benjohnemmett/Wingman/README.md

# Wingman
Hardware layout and code for a basic fixed wing flight controller.
