benjohnemmett/Wingman/(threads)

Thread 2 (2022-07-28):

ATMega4809 Library to Capture PWM input

benjohnemmett, 2022-07-28:
Write a small library to capture the 4 channels of servo PWM (typically 1 -2 ms @ 50Hz) for the ATMega4809. Keep all platform specific code out of FlightControllerMain.c and in a separate library to keep main code portable. Store captures values as TBD.

Options for storing the the PWM value?
- float 0.0 to 1.0 would be easy to work with and provide high resolution.
- uint8_t would make all operations atomic. Would that be enough resolution?
- Pulse width in ms (uint16_t) would be generic, but non-atomic.

* Note that it would be good to leave the option open for capturing additional PWM channels for future features.

benjohnemmett, 2022-08-17:
Completed using uint16 to store the most recent pulse width value of each channel in microseconds.

\* Note that using 16 bit values will require extra care to ensure that values are accessed atomically.

Closed 2022-08-17.

Thread 3 (2022-07-28):

Write direction control library

benjohnemmett, 2022-07-28:
Write a library function to map PWM input of roll & pitch, stored as TBD, into aircraft body angles (relative to down direction).

This will support a control mode where the operator sticks directly control the aircraft pitch and roll. This should be swappable with other control libraries.

Thread 6 (2022-08-17):

Create PWM Passthrough

benjohnemmett, 2022-08-17:
Create platform specific logic for ATMega4809 that outputs 4 PWM signals that follow the captured input. Use the Timer/Counter Type A.

Test with ATMega4809 test board input capture connected to RC receiver and output connected to aircraft servos or logic analyzer.

\* This may be replaced later with external PWM control.

benjohnemmett, 2022-08-28:
This was tested with an RC plane and was able to control elevator, rudder, ailerons, & propeller ESC. All four channels could not be tested with actual motors simultaneously without issues. It appears likely to be a current draw issue because the RC transmitter alarm sounded for low RX power. Even after disconnecting all but one motor, the MCU would not operate until it was restarted (done by reflashing the same program).

benjohnemmett, 2022-08-30:
Further power testing pinpointed the power issue that was mentioned in the last comment to be in the jumper wires used to power the servos from the ESC. By just extending the 3-pin connection coming from the ESC to the RC receiver with a pair of jumper wires, it was enough to cause low power issues where there were none before.

I may return to this testing with better jumper wires later on. For now, I measured the current draw of each servo motor independently to estimate the total power requirements of the servo power rail. I found they typically run 2.5 mA idle and 50 to 200 mA active which means that the servo power rail will need to support at least 800 mA for power drawn from the ESC connector to power the other 4 servos (rudder, elevator, 2x ailerons). I feel like that is enough to confidently move forward with the hardware design.

Closed 2022-08-28.
