benjohnemmett/Wingman/hardware/WingBoard/WingBoard.kicad_pcb

## KiCad design hardware/WingBoard/WingBoard.kicad_pcb (2022-09-21)

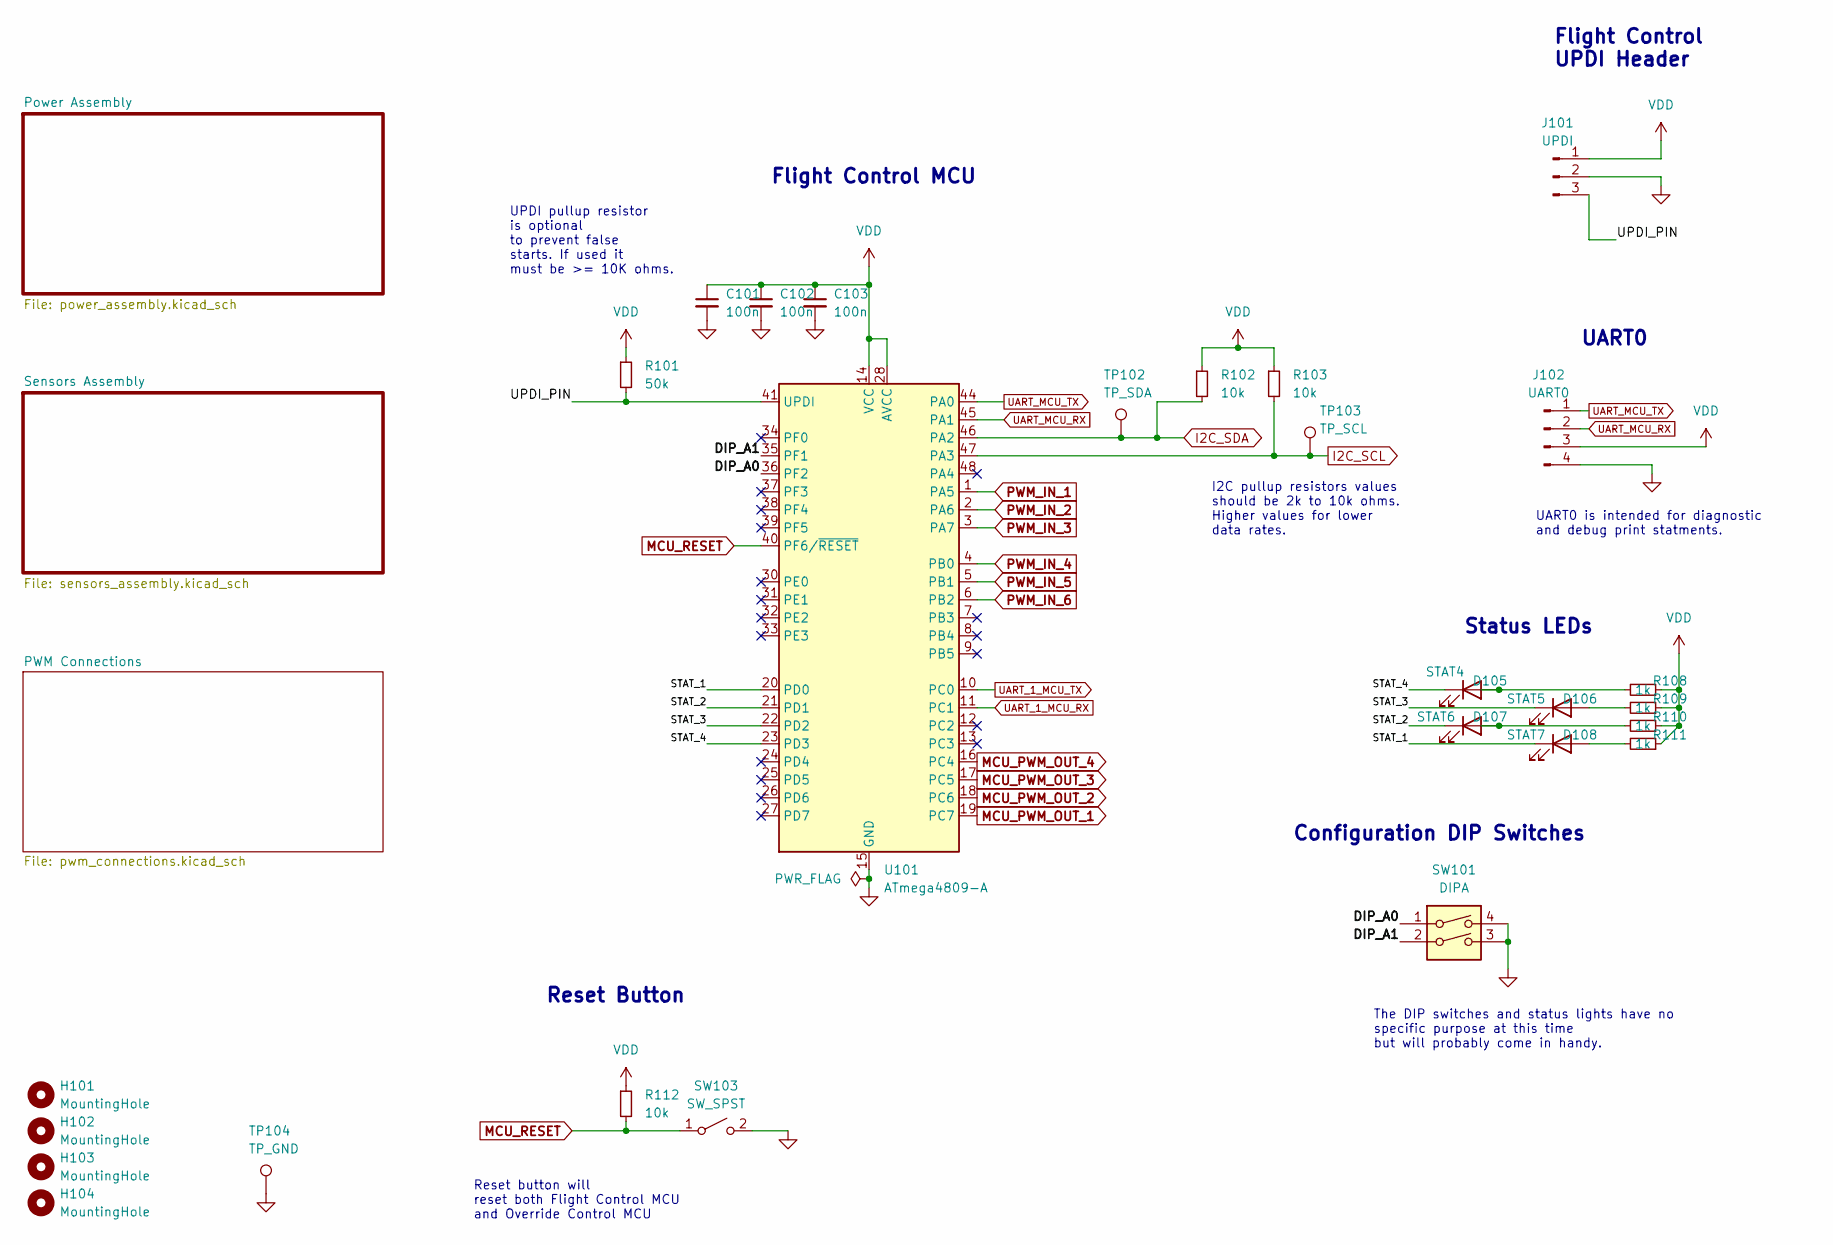
[picture p1: schematic WingBoard.kicad_sch]

Parts:
C101, C102, C103: 100n; C_0805_2012Metric_Pad1.18x1.45mm_HandSolder
D105: STAT4; LED_0805_2012Metric_Pad1.15x1.40mm_HandSolder
D106: STAT5; LED_0805_2012Metric_Pad1.15x1.40mm_HandSolder
D107: STAT6; LED_0805_2012Metric_Pad1.15x1.40mm_HandSolder
D108: STAT7; LED_0805_2012Metric_Pad1.15x1.40mm_HandSolder
H101, H102, H103, H104: MountingHole; MountingHole_3mm_Pad_Via
J101: UPDI; PinHeader_1x03_P2.54mm_Vertical
J102: UART0; PinHeader_1x04_P2.54mm_Vertical
R101: 50k; R_0805_2012Metric_Pad1.20x1.40mm_HandSolder
R102, R103, R112: 10k; R_0805_2012Metric_Pad1.20x1.40mm_HandSolder
R108, R109, R110, R111: 1k; R_0805_2012Metric_Pad1.20x1.40mm_HandSolder
SW101: DIPA; SW_DIP_SPSTx02_Slide_Copal_CHS-02B_W7.62mm_P1.27mm
SW103: SW_SPST; R-668127
TP102: TP_SDA; TestPoint_Pad_D1.5mm
TP103: TP_SCL; TestPoint_Pad_D1.5mm
TP104: TP_GND; TestPoint_Pad_D1.5mm
U101: ATmega4809-A; TQFP-48_7x7mm_P0.5mm

Connections:
/DIP_A0: SW101.1, U101.36 (PF2)
/DIP_A1: SW101.2, U101.35 (PF1)
/STAT_1: D108.1 (K), U101.20 (PD0)
/STAT_2: D107.1 (K), U101.21 (PD1)
/STAT_3: D106.1 (K), U101.22 (PD2)
/STAT_4: D105.1 (K), U101.23 (PD3)
/UPDI_PIN: J101.3, R101.2, U101.41 (UPDI)
GND: C101.2, C102.2, C103.2, J101.2, J102.4, SW101.3, SW101.4, SW103.2 (B), TP104.1, U101.15 (GND), U101.29 (GND), U101.43 (GND); also elsewhere on the board
I2C_SCL: R103.2, TP103.1, U101.47 (PA3); also elsewhere on the board
I2C_SDA: R102.2, TP102.1, U101.46 (PA2); also elsewhere on the board
MCU_PWM_OUT_1: U101.19 (PC7); also elsewhere on the board
MCU_PWM_OUT_2: U101.18 (PC6); also elsewhere on the board
MCU_PWM_OUT_3: U101.17 (PC5); also elsewhere on the board
MCU_PWM_OUT_4: U101.16 (PC4); also elsewhere on the board
MCU_RESET: R112.2, SW103.1 (A), U101.40 (PF6/~RESET); also elsewhere on the board
unnamed: D105.2 (A), R108.2
unnamed: D106.2 (A), R109.2
unnamed: D107.2 (A), R110.2
unnamed: D108.2 (A), R111.2
PWM_IN_1: U101.1 (PA5); also elsewhere on the board
PWM_IN_2: U101.2 (PA6); also elsewhere on the board
PWM_IN_3: U101.3 (PA7); also elsewhere on the board
PWM_IN_4: U101.4 (PB0); also elsewhere on the board
PWM_IN_5: U101.5 (PB1); also elsewhere on the board
PWM_IN_6: U101.6 (PB2); also elsewhere on the board
UART_1_MCU_RX: U101.11 (PC1); also elsewhere on the board
UART_1_MCU_TX: U101.10 (PC0); also elsewhere on the board
UART_MCU_RX: J102.2, U101.45 (PA1)
UART_MCU_TX: J102.1, U101.44 (PA0)
VDD: C101.1, C102.1, C103.1, J101.1, J102.3, R101.1, R102.1, R103.1, R108.1, R109.1, R110.1, R111.1, R112.1, U101.14 (VCC), U101.28 (AVCC), U101.42 (VCC); also elsewhere on the board

Notes on the sheet:
Configuration DIP Switches
Reset Button
Flight Control MCU
UPDI pullup resistor is optional to prevent false starts. If used it must be >= 10K ohms.
The DIP switches and status lights have no specific purpose at this time but will probably come in handy.
Reset button will reset both Flight Control MCU and Override Control MCU
Flight Control UPDI Header
Status LEDs
UART0 is intended for diagnostic and debug print statments.
I2C pullup resistors values should be 2k to 10k ohms. Higher values for lower data rates.
UART0

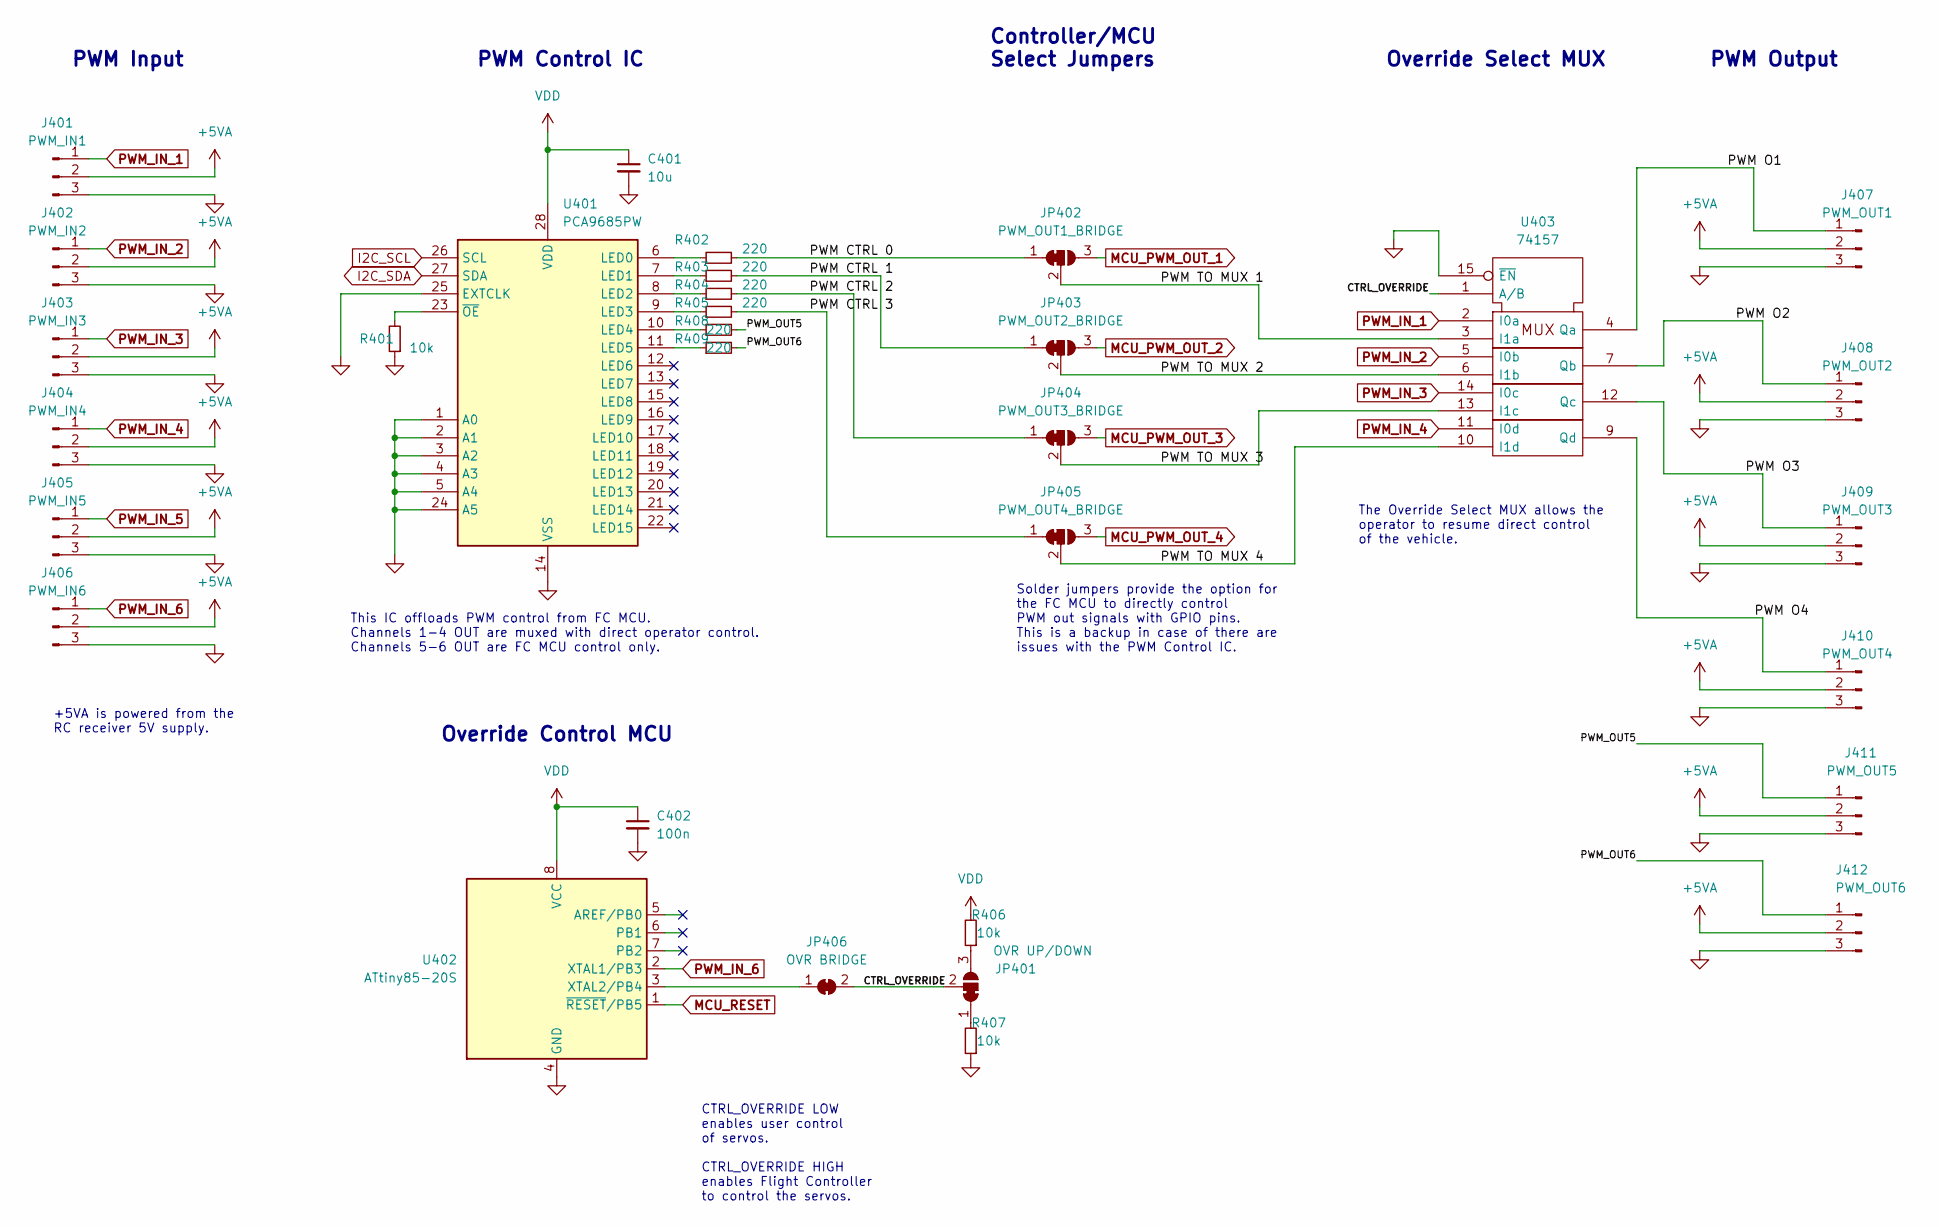
[picture p2: schematic pwm_connections.kicad_sch]

Parts:
C401: 10u; C_0805_2012Metric_Pad1.18x1.45mm_HandSolder
C402: 100n; C_0805_2012Metric_Pad1.18x1.45mm_HandSolder
J401: PWM_IN1; PinHeader_1x03_P2.54mm_Vertical
J402: PWM_IN2; PinHeader_1x03_P2.54mm_Vertical
J403: PWM_IN3; PinHeader_1x03_P2.54mm_Vertical
J404: PWM_IN4; PinHeader_1x03_P2.54mm_Vertical
J405: PWM_IN5; PinHeader_1x03_P2.54mm_Vertical
J406: PWM_IN6; PinHeader_1x03_P2.54mm_Vertical
J407: PWM_OUT1; PinHeader_1x03_P2.54mm_Vertical
J408: PWM_OUT2; PinHeader_1x03_P2.54mm_Vertical
J409: PWM_OUT3; PinHeader_1x03_P2.54mm_Vertical
J410: PWM_OUT4; PinHeader_1x03_P2.54mm_Vertical
J411: PWM_OUT5; PinHeader_1x03_P2.54mm_Vertical
J412: PWM_OUT6; PinHeader_1x03_P2.54mm_Vertical
JP401: OVR UP/DOWN; SolderJumper-3_P1.3mm_Bridged2Bar12_Pad1.0x1.5mm
JP402: PWM_OUT1_BRIDGE; SolderJumper-3_P1.3mm_Bridged12_Pad1.0x1.5mm
JP403: PWM_OUT2_BRIDGE; SolderJumper-3_P1.3mm_Bridged12_Pad1.0x1.5mm
JP404: PWM_OUT3_BRIDGE; SolderJumper-3_P1.3mm_Bridged12_Pad1.0x1.5mm
JP405: PWM_OUT4_BRIDGE; SolderJumper-3_P1.3mm_Bridged12_Pad1.0x1.5mm
JP406: OVR BRIDGE; SolderJumper-2_P1.3mm_Bridged2Bar_RoundedPad1.0x1.5mm
R401, R406, R407: 10k; R_0805_2012Metric_Pad1.20x1.40mm_HandSolder
R402, R403, R404, R405, R408, R409: 220; R_0805_2012Metric_Pad1.20x1.40mm_HandSolder
U401: PCA9685PW; TSSOP-28_4.4x9.7mm_P0.65mm
U402: ATtiny85-20S; SOIC-8W_5.3x5.3mm_P1.27mm
U403: 74157; SOP65P640X120-16N

Connections:
+5VA: J401.2, J402.2, J403.2, J404.2, J405.2, J406.2, J407.2, J408.2, J409.2, J410.2, J411.2, J412.2; also elsewhere on the board
/PWM Connections/CTRL_OVERRIDE: JP401.2 (C), JP406.2 (B), U403.1 (A/B)
/PWM Connections/PWM CTRL 0: JP402.1 (A), R402.2
/PWM Connections/PWM CTRL 1: JP403.1 (A), R403.2
/PWM Connections/PWM CTRL 2: JP404.1 (A), R404.2
/PWM Connections/PWM CTRL 3: JP405.1 (A), R405.2
/PWM Connections/PWM O1: J407.1, U403.4 (Qa)
/PWM Connections/PWM O2: J408.1, U403.7 (Qb)
/PWM Connections/PWM O3: J409.1, U403.12 (Qc)
/PWM Connections/PWM O4: J410.1, U403.9 (Qd)
/PWM Connections/PWM TO MUX 1: JP402.2 (C), U403.3 (I1a)
/PWM Connections/PWM TO MUX 2: JP403.2 (C), U403.6 (I1b)
/PWM Connections/PWM TO MUX 3: JP404.2 (C), U403.13 (I1c)
/PWM Connections/PWM TO MUX 4: JP405.2 (C), U403.10 (I1d)
/PWM Connections/PWM_OUT5: J411.1, R408.2
/PWM Connections/PWM_OUT6: J412.1, R409.2
GND: C401.2, C402.2, J401.3, J402.3, J403.3, J404.3, J405.3, J406.3, J407.3, J408.3, J409.3, J410.3, J411.3, J412.3, R401.1, R407.1, U401.1 (A0), U401.2 (A1), U401.3 (A2), U401.4 (A3), U401.5 (A4), U401.14 (VSS), U401.24 (A5), U401.25 (EXTCLK), U402.4 (GND), U403.8 (GND), U403.15 (~EN); also elsewhere on the board
I2C_SCL: U401.26 (SCL); also elsewhere on the board
I2C_SDA: U401.27 (SDA); also elsewhere on the board
MCU_PWM_OUT_1: JP402.3 (B); also elsewhere on the board
MCU_PWM_OUT_2: JP403.3 (B); also elsewhere on the board
MCU_PWM_OUT_3: JP404.3 (B); also elsewhere on the board
MCU_PWM_OUT_4: JP405.3 (B); also elsewhere on the board
MCU_RESET: U402.1 (~RESET/PB5); also elsewhere on the board
unnamed: JP401.1 (A), R407.2
unnamed: JP401.3 (B), R406.1
unnamed: JP406.1 (A), U402.3 (XTAL2/PB4)
unnamed: R401.2, U401.23 (~OE)
unnamed: R402.1, U401.6 (LED0)
unnamed: R403.1, U401.7 (LED1)
unnamed: R404.1, U401.8 (LED2)
unnamed: R405.1, U401.9 (LED3)
unnamed: R408.1, U401.10 (LED4)
unnamed: R409.1, U401.11 (LED5)
PWM_IN_1: J401.1, U403.2 (I0a); also elsewhere on the board
PWM_IN_2: J402.1, U403.5 (I0b); also elsewhere on the board
PWM_IN_3: J403.1, U403.14 (I0c); also elsewhere on the board
PWM_IN_4: J404.1, U403.11 (I0d); also elsewhere on the board
PWM_IN_5: J405.1; also elsewhere on the board
PWM_IN_6: J406.1, U402.2 (XTAL1/PB3); also elsewhere on the board
VDD: C401.1, C402.1, R406.2, U401.28 (VDD), U402.8 (VCC), U403.16 (VDD); also elsewhere on the board

Notes on the sheet:
+5VA is powered from the RC receiver 5V supply.
CTRL_OVERRIDE LOW enables user control of servos. CTRL_OVERRIDE HIGH enables Flight Controller to control the servos.
PWM Control IC
The Override Select MUX allows the operator to resume direct control of the vehicle.
PWM Input
PWM Output
Override Control MCU
Solder jumpers provide the option for the FC MCU to directly control PWM out signals with GPIO pins. This is a backup in case of there are issues with the PWM Control IC.
Controller/MCU Select Jumpers
This IC offloads PWM control from FC MCU. Channels 1-4 OUT are muxed with direct operator control. Channels 5-6 OUT are FC MCU control only.
Override Select MUX

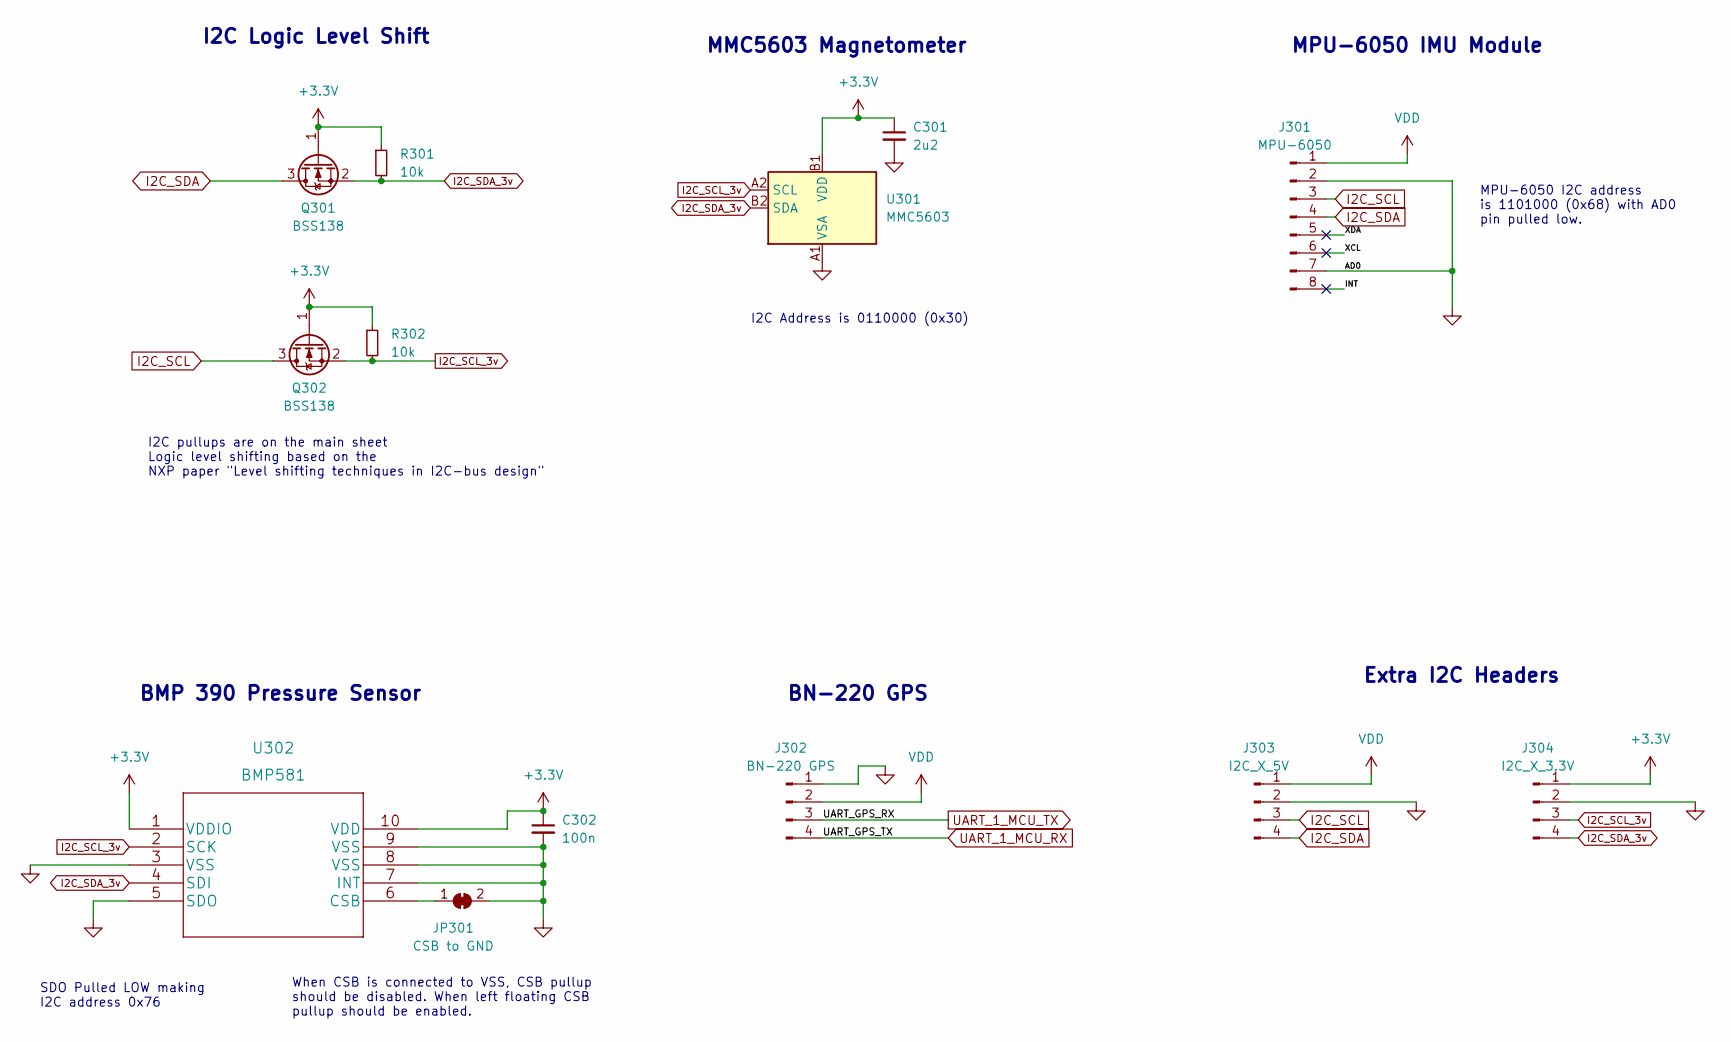
[picture p3: schematic sensors_assembly.kicad_sch]

Parts:
C301: 2u2; C_0805_2012Metric_Pad1.18x1.45mm_HandSolder
C302: 100n; C_0805_2012Metric_Pad1.18x1.45mm_HandSolder
J301: MPU-6050; PinHeader_1x08_P2.54mm_Vertical
J302: BN-220 GPS; JST_SH_BM04B-SRSS-TB_1x04-1MP_P1.00mm_Vertical
J303: I2C_X_5V; JST_SH_BM04B-SRSS-TB_1x04-1MP_P1.00mm_Vertical
J304: I2C_X_3.3V; JST_SH_BM04B-SRSS-TB_1x04-1MP_P1.00mm_Vertical
JP301: CSB to GND; SolderJumper-2_P1.3mm_Bridged_RoundedPad1.0x1.5mm
Q301, Q302: BSS138; SOT-23
R301, R302: 10k; R_0805_2012Metric_Pad1.20x1.40mm_HandSolder
U301: MMC5603; WLP-4_0.86x0.86mm_P0.4mm
U302: BMP581

Connections:
+3V3: C301.1, C302.1, J304.1, Q301.1 (G), Q302.1 (G), R301.1, R302.1, U301.B1 (VDD), U302.1 (VDDIO), U302.10 (VDD); also elsewhere on the board
/Sensors Assembly/INT: J301.8
/Sensors Assembly/XCL: J301.6
/Sensors Assembly/XDA: J301.5
GND: C301.2, C302.2, J301.2, J301.7, J302.1, J303.2, J304.2, JP301.2 (B), U301.A1 (VSA), U302.3 (VSS), U302.5 (SDO), U302.7 (INT), U302.8 (VSS), U302.9 (VSS); also elsewhere on the board
I2C_SCL: J301.3, J303.3, Q302.3 (D); also elsewhere on the board
I2C_SCL_3v: J304.3, Q302.2 (S), R302.2, U301.A2 (SCL), U302.2 (SCK)
I2C_SDA: J301.4, J303.4, Q301.3 (D); also elsewhere on the board
I2C_SDA_3v: J304.4, Q301.2 (S), R301.2, U301.B2 (SDA), U302.4 (SDI)
unnamed: JP301.1 (A), U302.6 (CSB)
UART_1_MCU_RX: J302.4; also elsewhere on the board
UART_1_MCU_TX: J302.3; also elsewhere on the board
VDD: J301.1, J302.2, J303.1; also elsewhere on the board

Notes on the sheet:
I2C pullups are on the main sheet Logic level shifting based on the NXP paper "Level shifting techniques in I2C-bus design"
BMP 390 Pressure Sensor
SDO Pulled LOW making I2C address 0x76
I2C Address is 0110000 (0x30)
MPU-6050 IMU Module
BN-220 GPS
Extra I2C Headers
MMC5603 Magnetometer
MPU-6050 I2C address is 1101000 (0x68) with AD0 pin pulled low.
When CSB is connected to VSS, CSB pullup should be disabled. When left floating CSB pullup should be enabled.
I2C Logic Level Shift

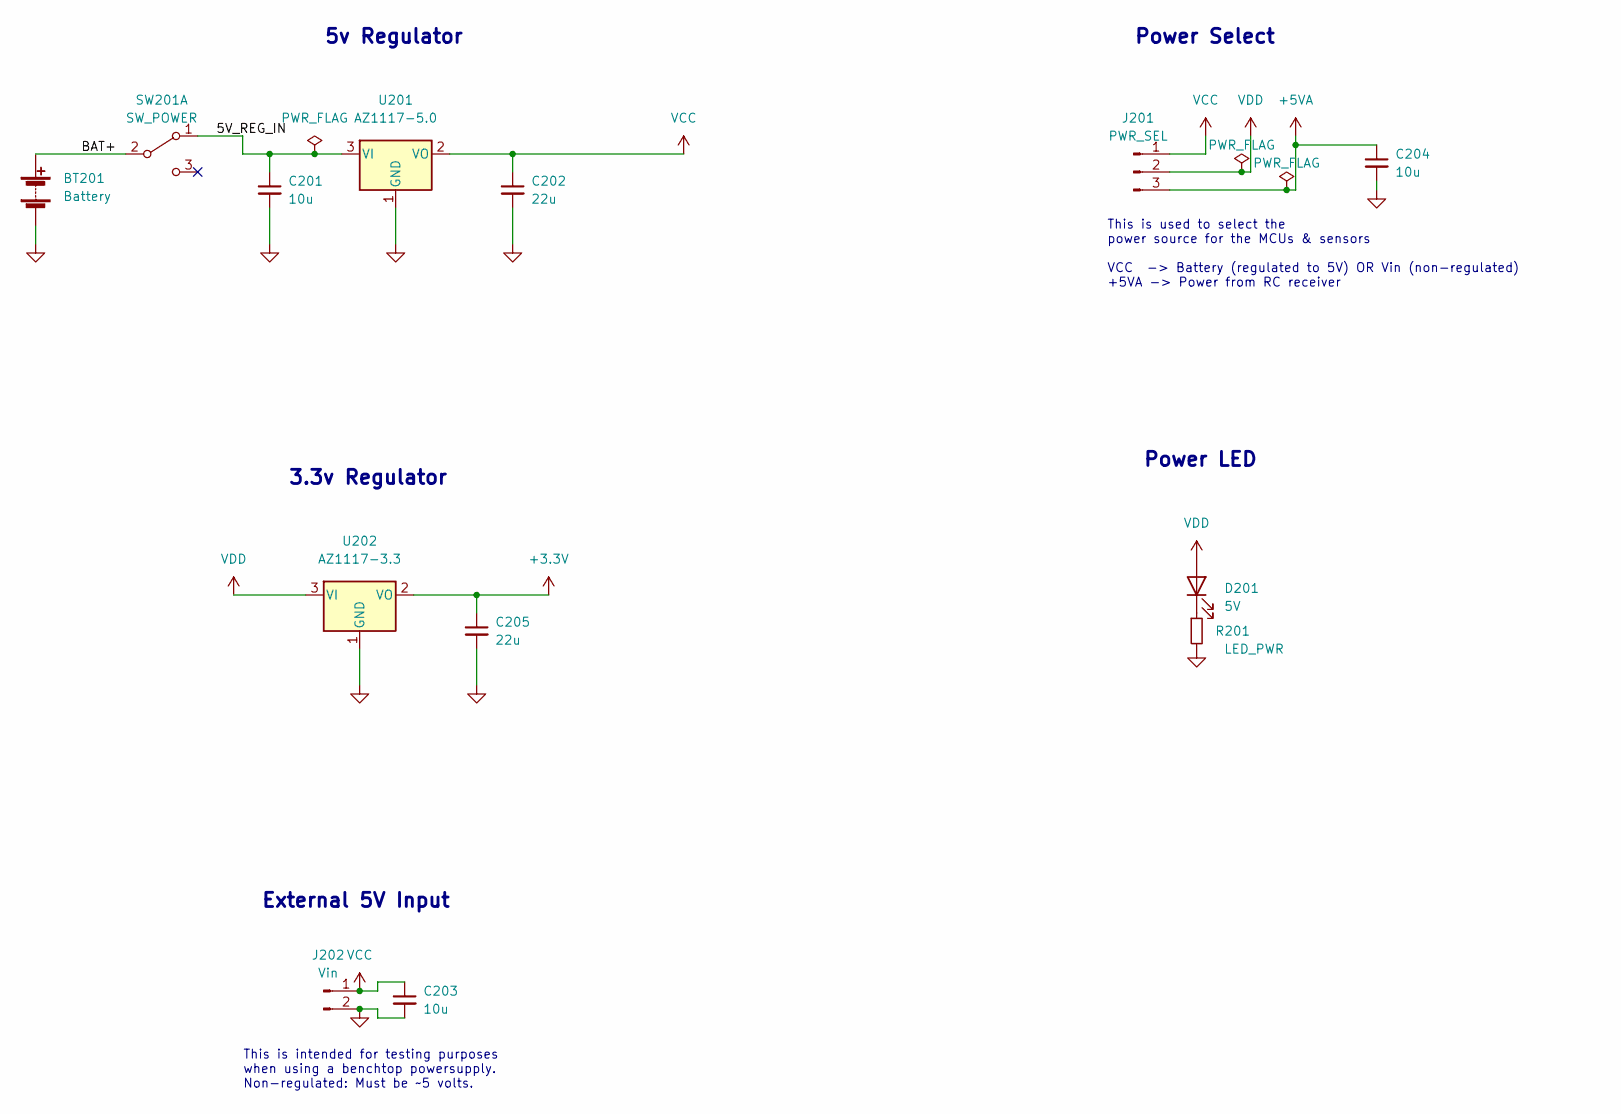
[picture p4: schematic power_assembly.kicad_sch]

Parts:
BT201: Battery; AMASS_XT30U-M_1x02_P5.0mm_Vertical
C201, C204: 10u; CP_Radial_D4.0mm_P1.50mm
C202, C205: 22u; CP_Radial_D4.0mm_P1.50mm
C203: 10u; C_0805_2012Metric_Pad1.18x1.45mm_HandSolder
D201: 5V; LED_0805_2012Metric_Pad1.15x1.40mm_HandSolder
J201: PWR_SEL; PinHeader_1x03_P2.54mm_Vertical
J202: Vin; PinHeader_1x02_P2.54mm_Vertical
R201: LED_PWR; R_0805_2012Metric_Pad1.20x1.40mm_HandSolder
SW201: SW_POWER; SW_DPDT_MSS22D18_6pin_bje
U201: AZ1117-5.0; AZ1117CH-5.0TRG1
U202: AZ1117-3.3; AZ1117CR-3.3TRG1

Connections:
+3V3: C205.1, U202.2 (VO); also elsewhere on the board
+5VA: C204.1, J201.3; also elsewhere on the board
/Power Assembly/5V_REG_IN: C201.1, SW201.1 (A), U201.3 (VI)
/Power Assembly/BAT+: BT201.1 (+), SW201.2 (B)
GND: BT201.2 (-), C201.2, C202.2, C203.2, C204.2, C205.2, J202.2, R201.2, U201.1 (GND), U202.1 (GND); also elsewhere on the board
unnamed: D201.1 (K), R201.1
VCC: C202.1, C203.1, J201.1, J202.1, U201.2 (VO)
VDD: D201.2 (A), J201.2, U202.3 (VI); also elsewhere on the board

Notes on the sheet:
This is intended for testing purposes when using a benchtop powersupply. Non-regulated: Must be ~5 volts.
5v Regulator
3.3v Regulator
Power LED
Power Select
External 5V Input
This is used to select the power source for the MCUs & sensors VCC -> Battery (regulated to 5V) OR Vin (non-regulated) +5VA -> Power from RC receiver

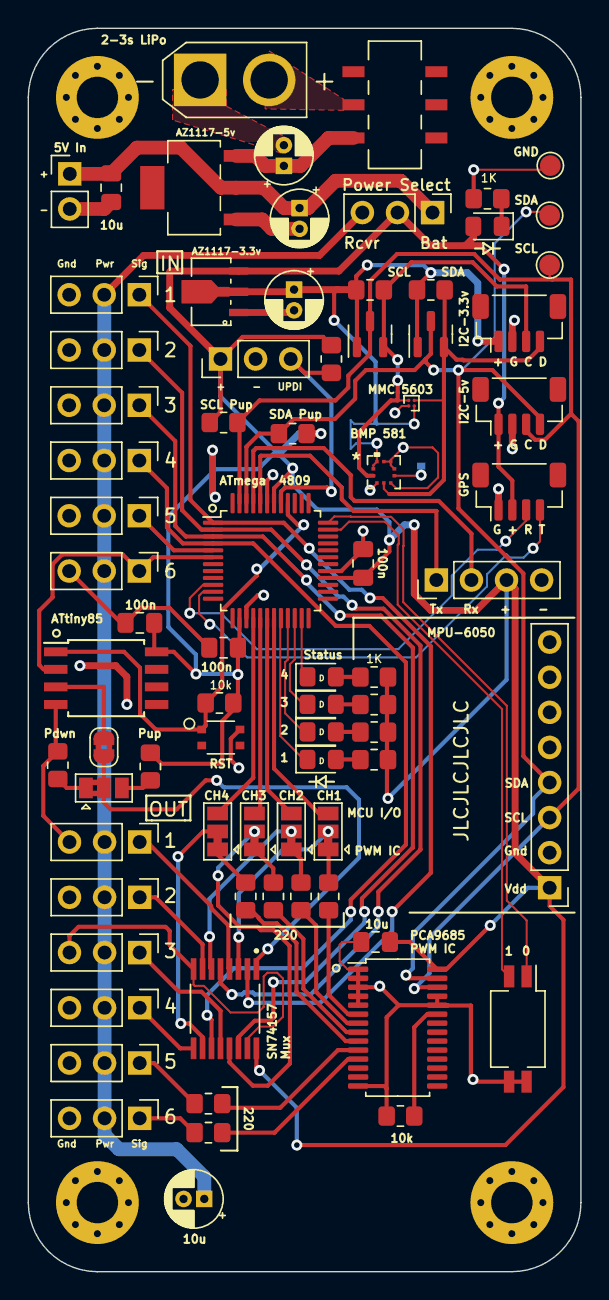
[picture p5: board WingBoard.kicad_pcb from above]

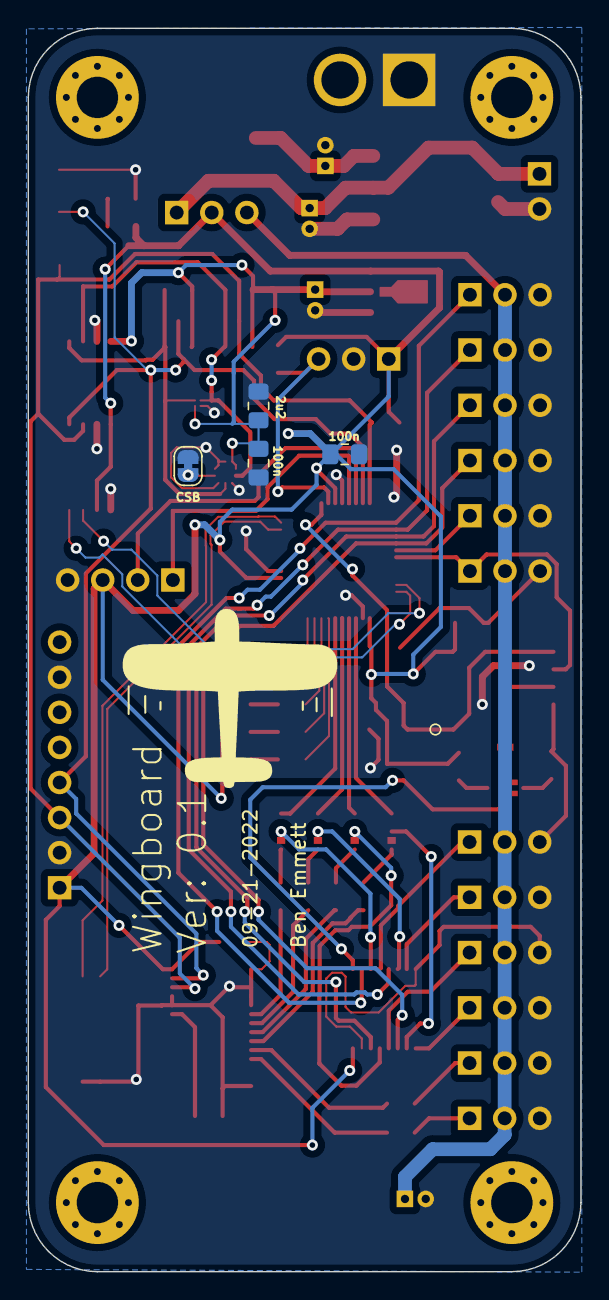
[picture p6: board WingBoard.kicad_pcb from below]

Board: 2 copper layers, 40.0 x 90.0 mm, 85 parts (4 on the bottom side), 64 nets.
