benjohnemmett/Wingman/firmware/FlightLogger.X/Wingboard_ATMega4809.h

/* 
 * File:   Wingboard.h
 * Author: ben
 *
 * Created on July 9, 2023, 10:47 PM
 */

#ifndef WINGBOARD_H
#define	WINGBOARD_H

#include <avr/io.h>

#ifdef	__cplusplus
extern "C" {
#endif

#ifdef	__cplusplus
}
#endif

#endif	/* WINGBOARD_H */
