benjohnemmett/Wingman/(commit log)

2022-07-08 Add pct pwm range check, override hysteresis, and default pulse ready to 0
2022-07-17 Added more PID controller tests.
2022-07-28 Cleaned up pid controller & tests.
2022-08-09 Added integrator limits to the PID controller.
2022-08-14 ATMega4809 UART support added. Hardware test successful.
2022-08-15 Configured pin interrupts for PWM input capture pins. Tested & working.
2022-08-17 Configured 4-channel PWM input capture. Tested & working on ATMega4809.
2022-08-18 Fixed issue to correct stored pulse width values.
    [HAL_ATMega4809.c]
2022-08-23 Added PWM output logic. Tested & working.
2022-08-23 Updated to make PWM output more accurate.
2022-08-28 Passthrough improved. Tested on RC plane elevator + rudder, working.
2022-09-07 Moved atmega4809 UART code to separate library.
2022-09-08 Schematic design started.
    [WingBoard.kicad_pcb, WingBoard.kicad_sch, power_assembly.kicad_sch, pwm_connections.kicad_sch, sensors_assembly.kicad_sch]
2022-09-08 Added extra I2C headers to the schematic.
    [WingBoard.kicad_sch, sensors_assembly.kicad_sch]
2022-09-08 Added pwm controller.
    [WingBoard.kicad_sch, control_override.kicad_sch, pwm_connections.kicad_sch]
2022-09-09 Hardware update: status LEDs, DIP switches, & test points.
    [WingBoard.kicad_sch, power_assembly.kicad_sch, pwm_connections.kicad_sch, sensors_assembly.kicad_sch]
2022-09-10 Minor hardware design updates and assigned PCB footprints
    [WingBoard.kicad_sch, power_assembly.kicad_sch, pwm_connections.kicad_sch, sensors_assembly.kicad_sch]
2022-09-11 PCB rough layout done.
    [WingBoard.kicad_pcb, WingBoard.kicad_sch, power_assembly.kicad_sch, pwm_connections.kicad_sch, sensors_assembly.kicad_sch]
2022-09-19 Hardware layout v0.1 complete.
    [WingBoard.kicad_pcb, WingBoard.kicad_sch, power_assembly.kicad_sch, pwm_connections.kicad_sch, sensors_assembly.kicad_sch]
2022-09-21 Final wingboard v0.1 hardware design.
    [WingBoard.kicad_pcb, WingBoard.kicad_sch, pwm_connections.kicad_sch]
2022-10-09 Added code to test status LEDs on startup.
2022-10-11 Reading DIP switches.
2023-07-03 Added PID reset function.
    [PidController.c, PidController.h]
2023-07-03 Added PID integrator bounds tests.
2023-07-05 Added unit tests for PID controller for dt != 1.0
2023-07-07 Added simple python wrapper to test PID library.
2023-08-01 Pulled in MPU-6050 updates from submodule & updated flight logger to write gyro data.
2024-01-15 FlightLogger print cleanup.
2024-01-16 Added pressure & temp to FlightLogger.
2024-02-16 FlightLogger logs PWM in 1-4.
2024-06-23 Updated to use mcu-device-util library
2024-09-21 Updated override controller pin change interrupt.
2024-09-25 Status LED 4 toggles on each update loop iteration.
